n-ponto/SmartFaucet/images/noisy derivative.png

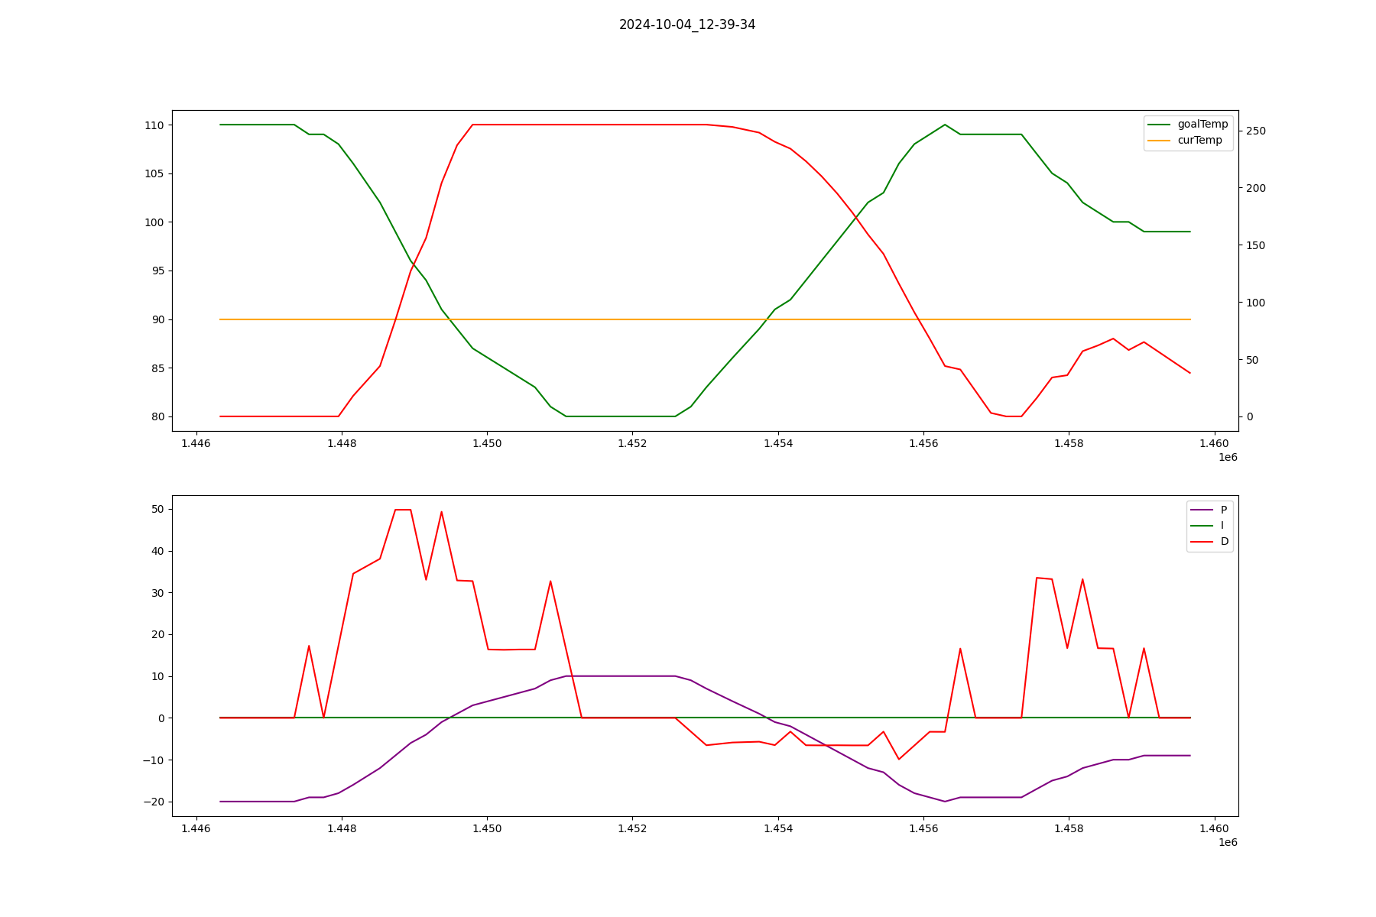
images/noisy derivative.png
