n-ponto/SmartFaucet/images/oscillating.png

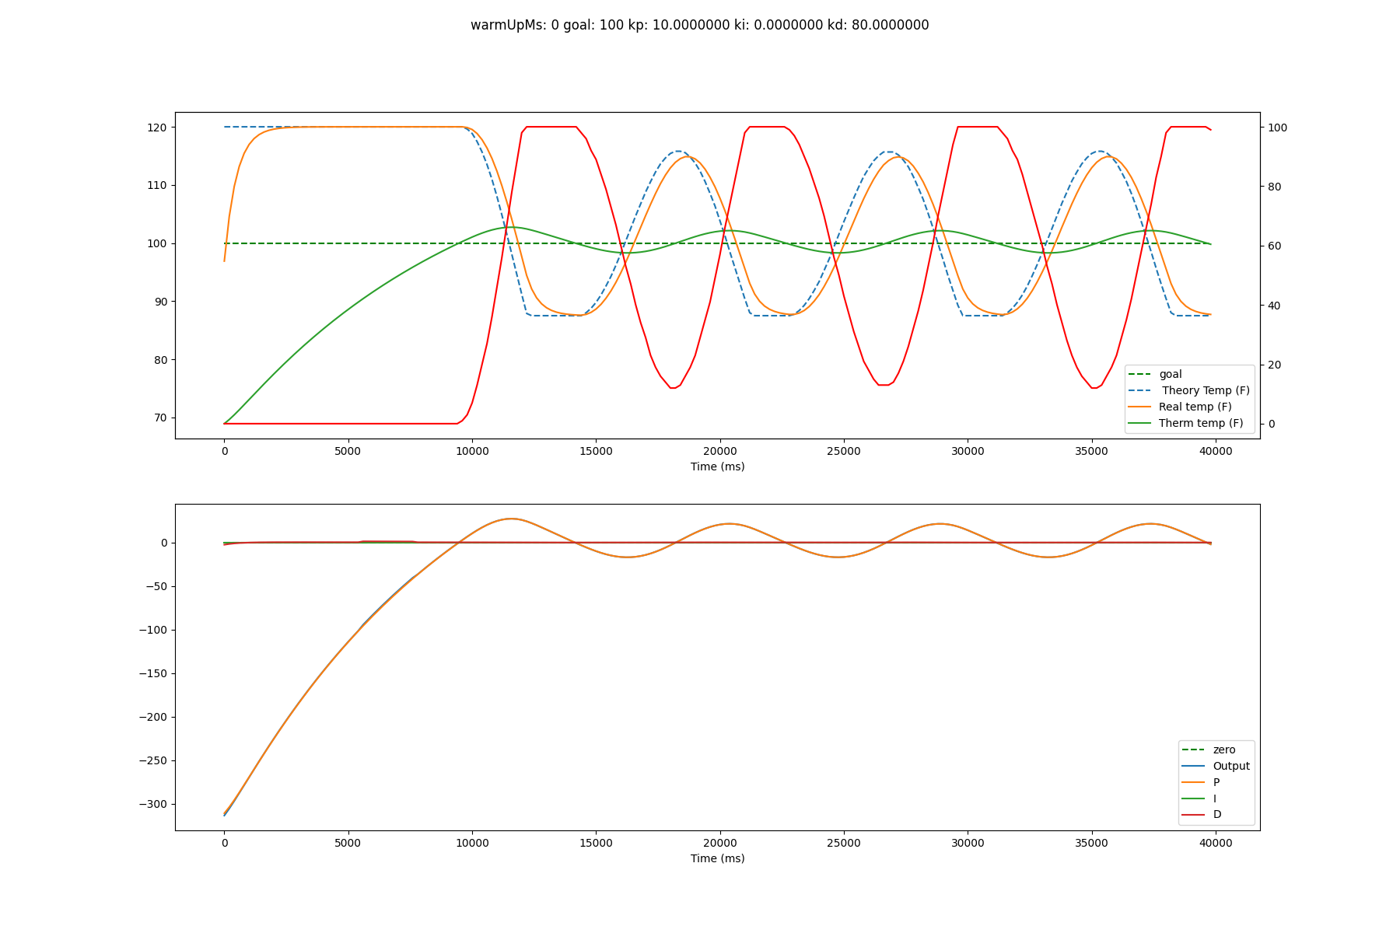
images/oscillating.png
