n-ponto/SmartFaucet/images/smooth derivative.png

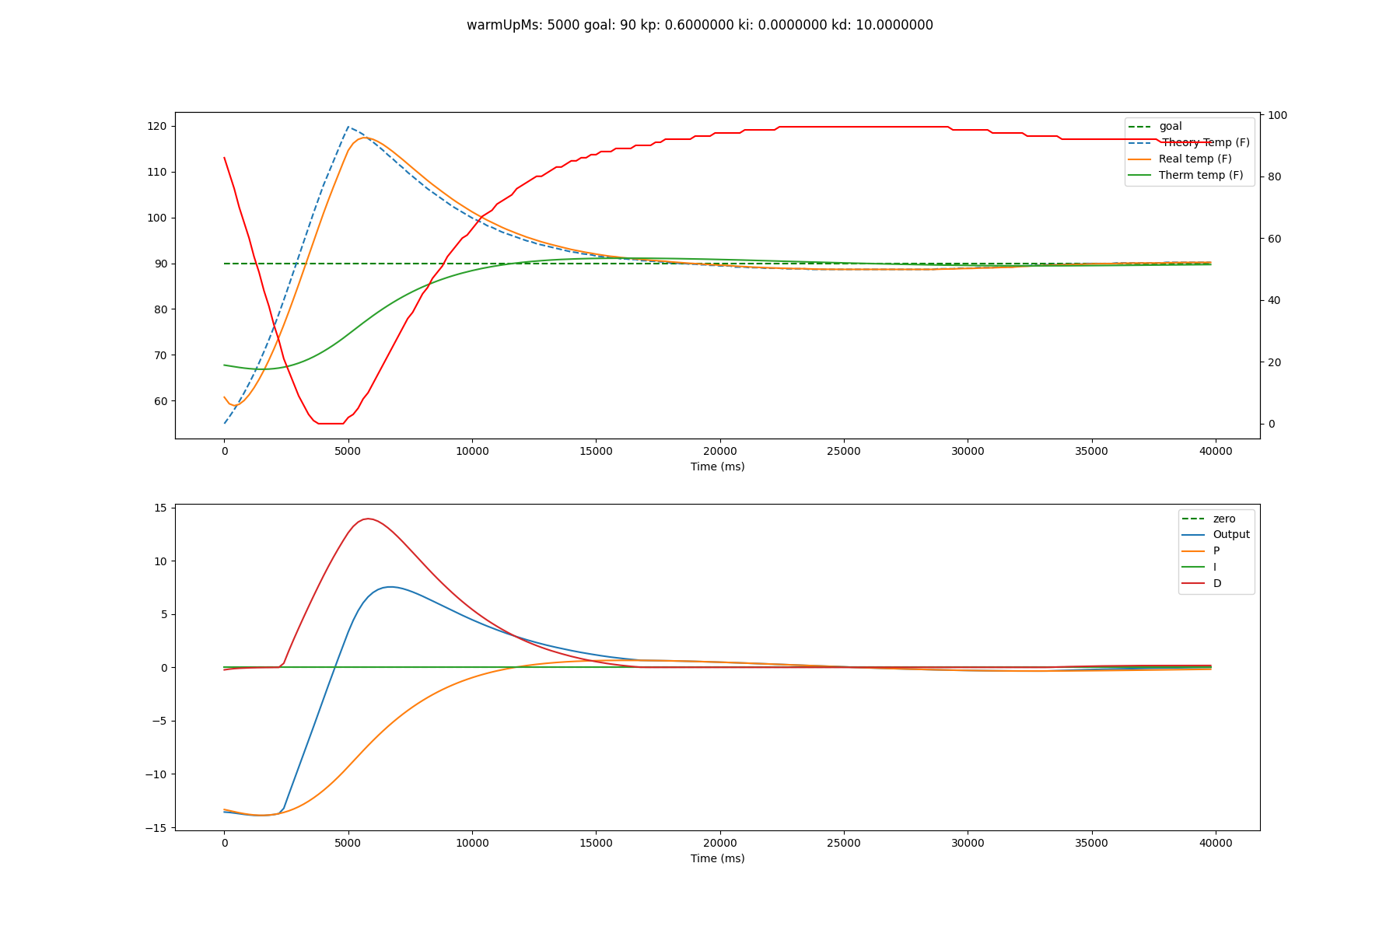
images/smooth derivative.png
