n-ponto/SmartFaucet/temp_controller/constants.h

#ifndef CONSTANTS_H_

#define MOTOR_DISABLE_DELAY 3000  // Time in ms before disabling the motor
#define SAMPLE_PERIOD 200         // Delay in ms between updates
#define MAX_FAUCET 255            // Max value for the faucet
// #define OUPUT_NOISE_FILTER 0     // Amount of output noise to ignore
#define SERVO_REFRESH_DELAY 20    // ms delay between servo refreshes

#endif  // CONSTANTS_H_
