n-ponto/SmartFaucet/(commit log)

2024-09-28 temp is float not uint8_t tuned PID controller
2024-10-02 tune PID + simulation
